daniel-theunissen/sar_adc/adc_tb.png

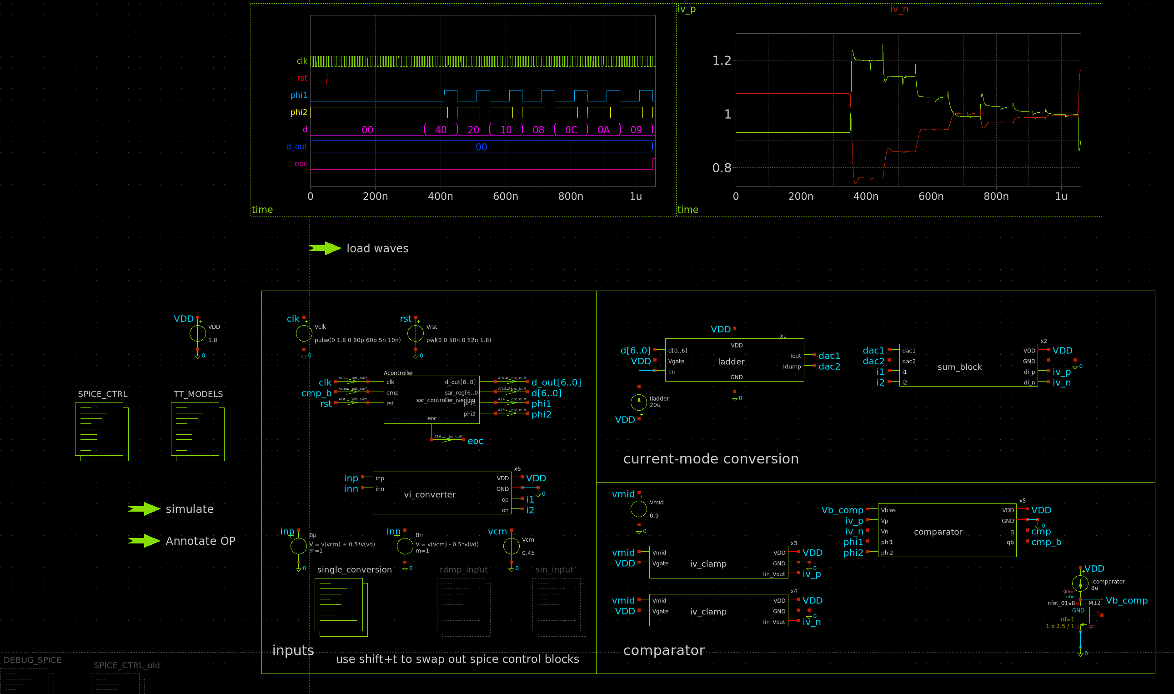
adc_tb.png
