daniel-theunissen/sar_adc/plots/clamp.png

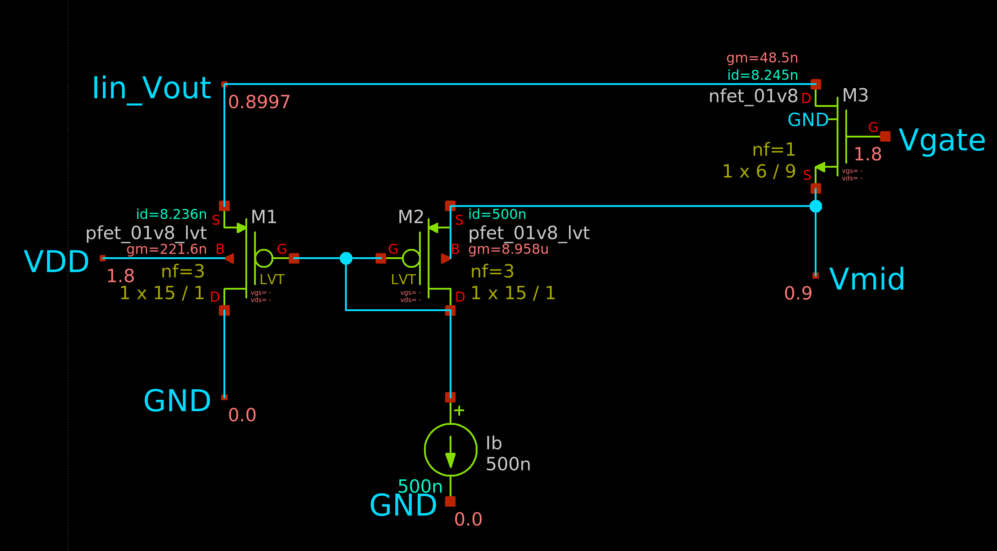
plots/clamp.png
