daniel-theunissen/sar_adc/plots/clamp_curve.png

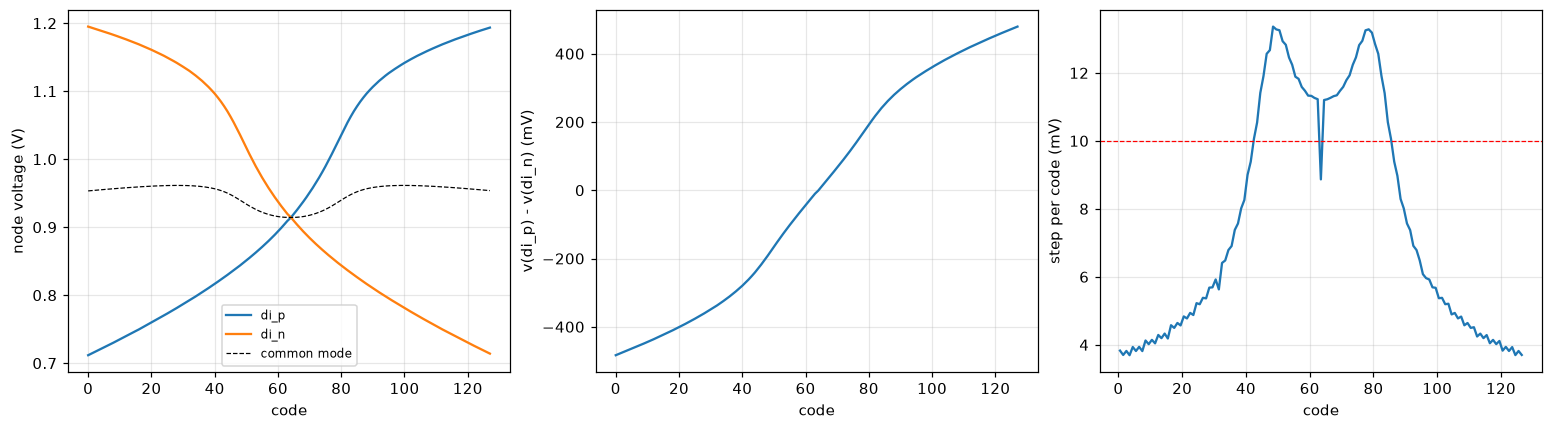
plots/clamp_curve.png
