daniel-theunissen/sar_adc/plots/comparator.png

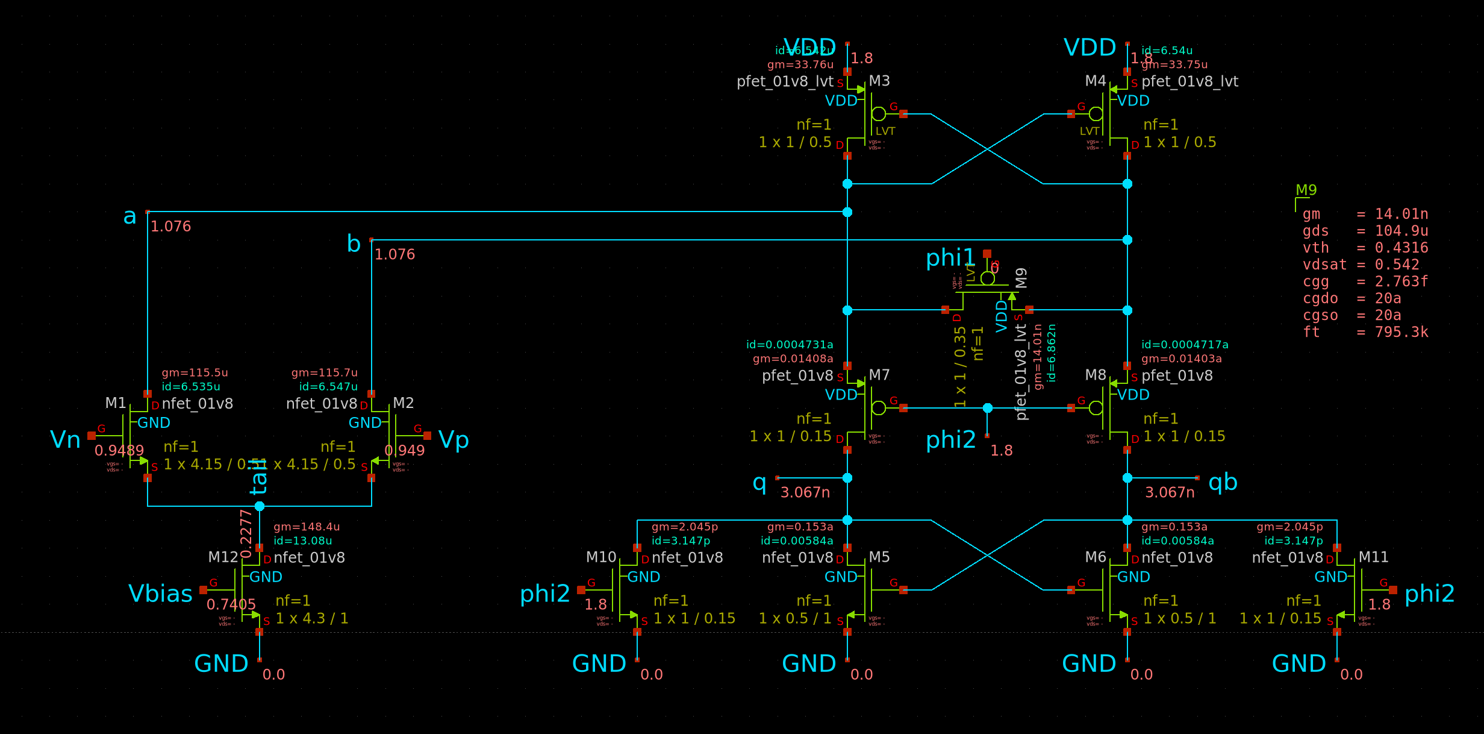
plots/comparator.png
