daniel-theunissen/sar_adc/plots/comparator_tb.png

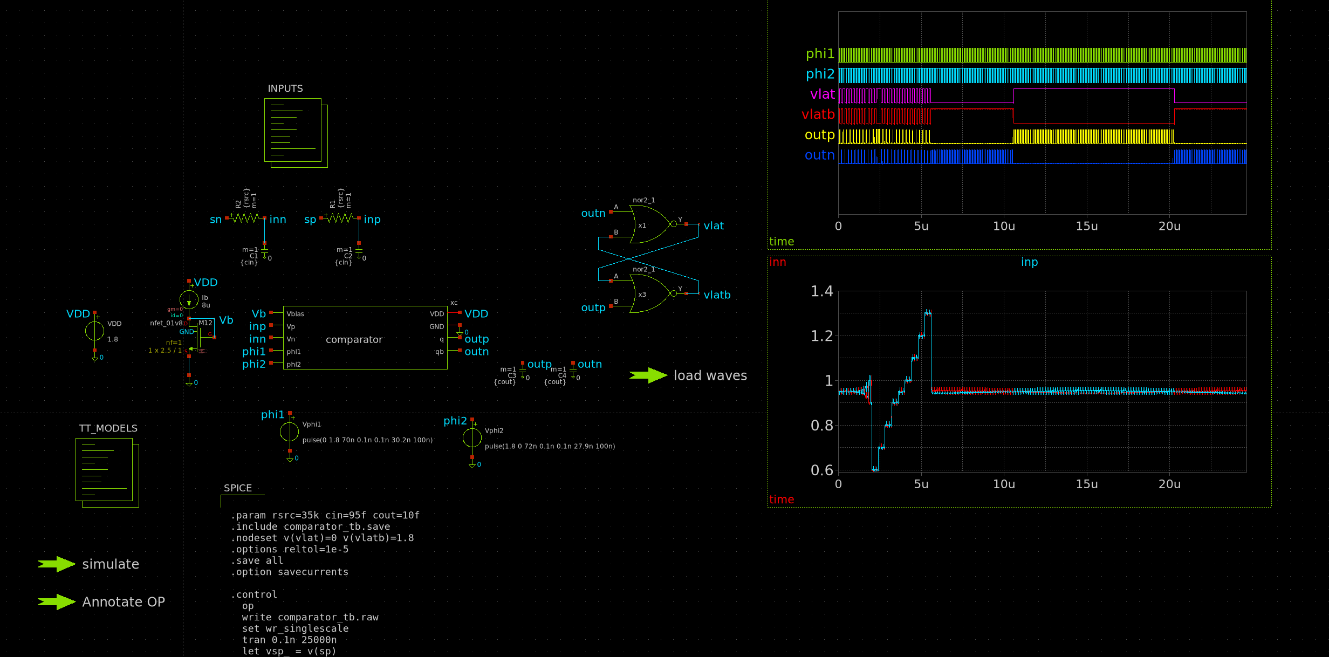
plots/comparator_tb.png
