daniel-theunissen/sar_adc/plots/ladder.png

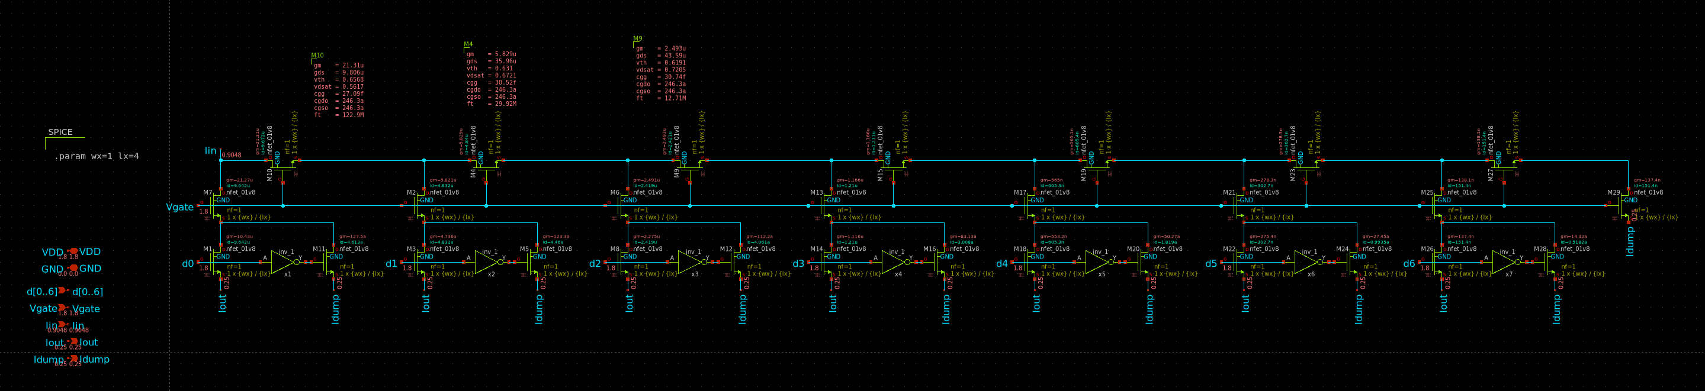
plots/ladder.png
