daniel-theunissen/sar_adc/plots/ladder_linearity.png

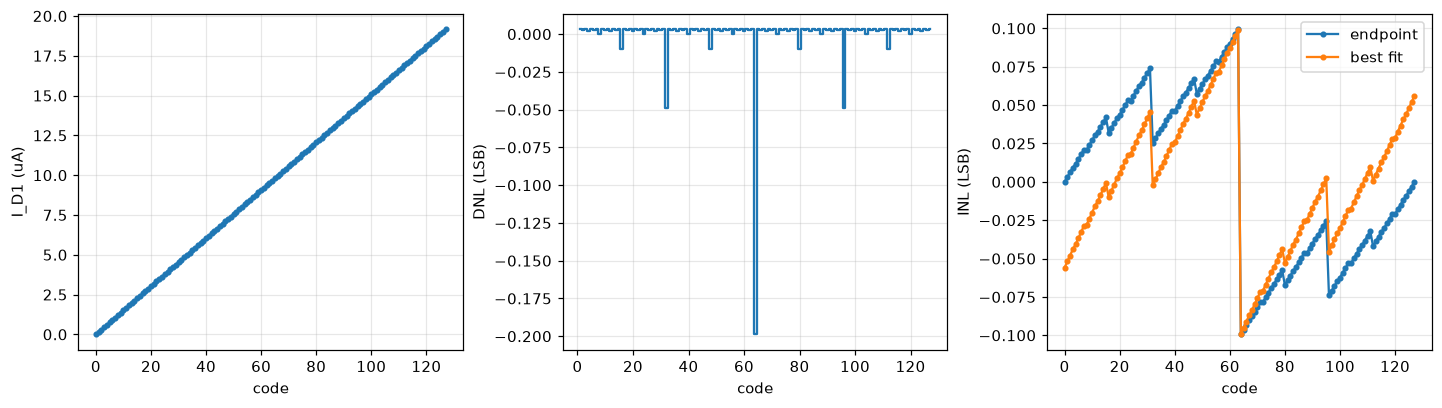
plots/ladder_linearity.png
