daniel-theunissen/sar_adc/plots/sum_stage.png

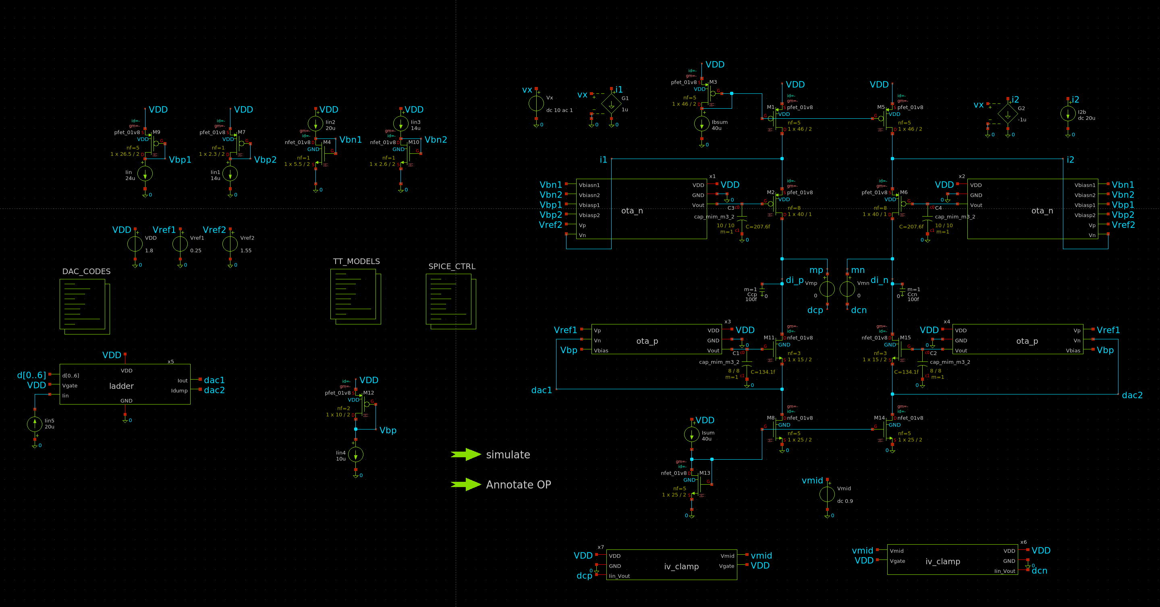
plots/sum_stage.png
