daniel-theunissen/sar_adc/plots/sum_stage_linearity.png

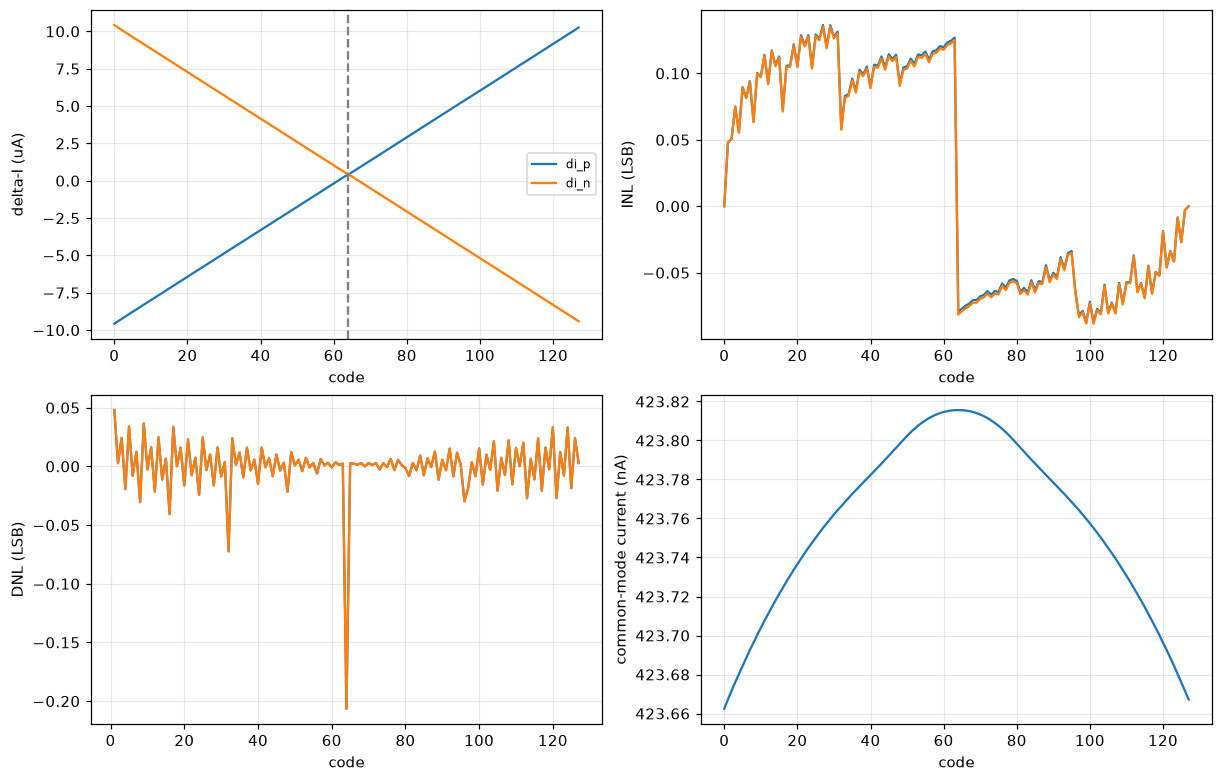
plots/sum_stage_linearity.png
