daniel-theunissen/sar_adc/plots/sum_stage_ota_n.png

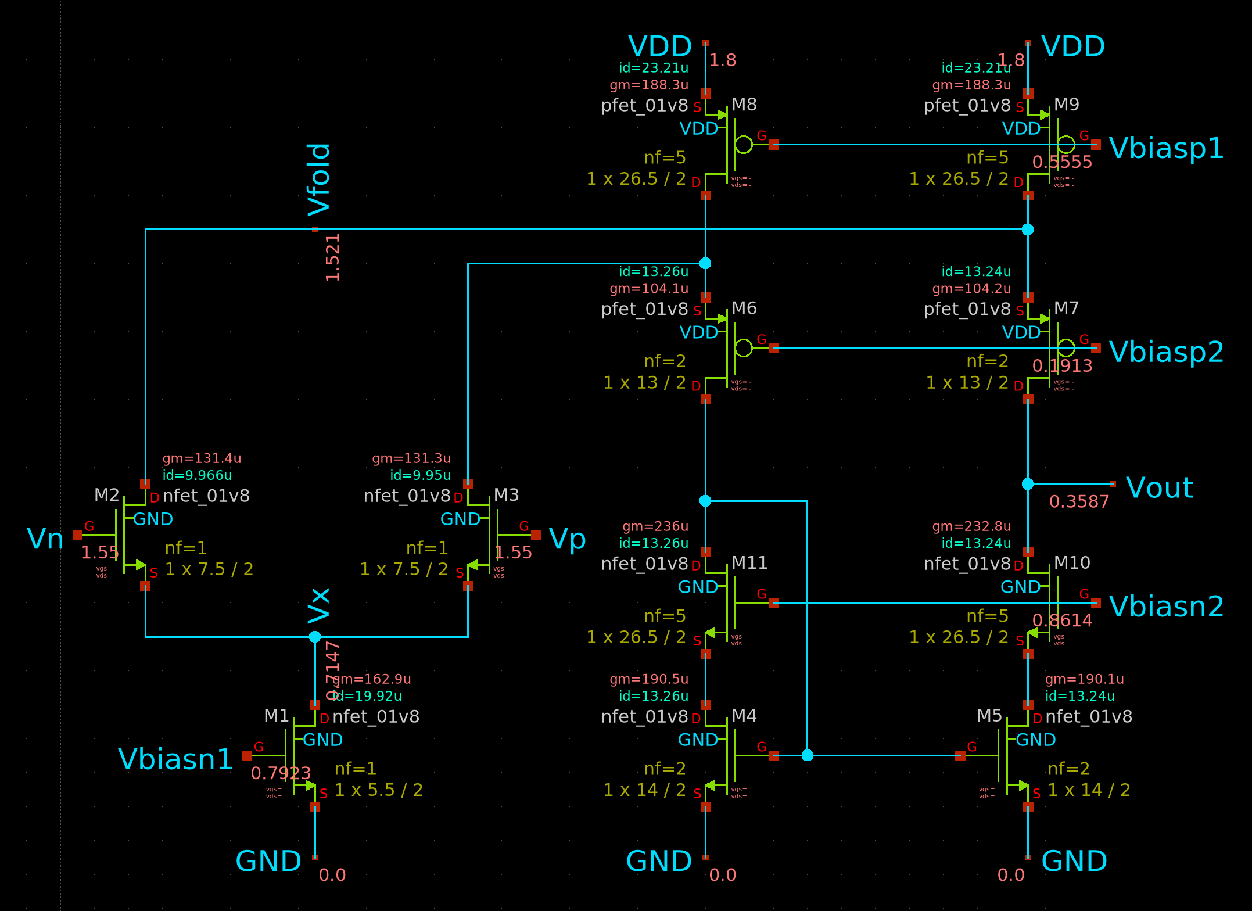
plots/sum_stage_ota_n.png
