daniel-theunissen/sar_adc/plots/sum_stage_ota_p.png

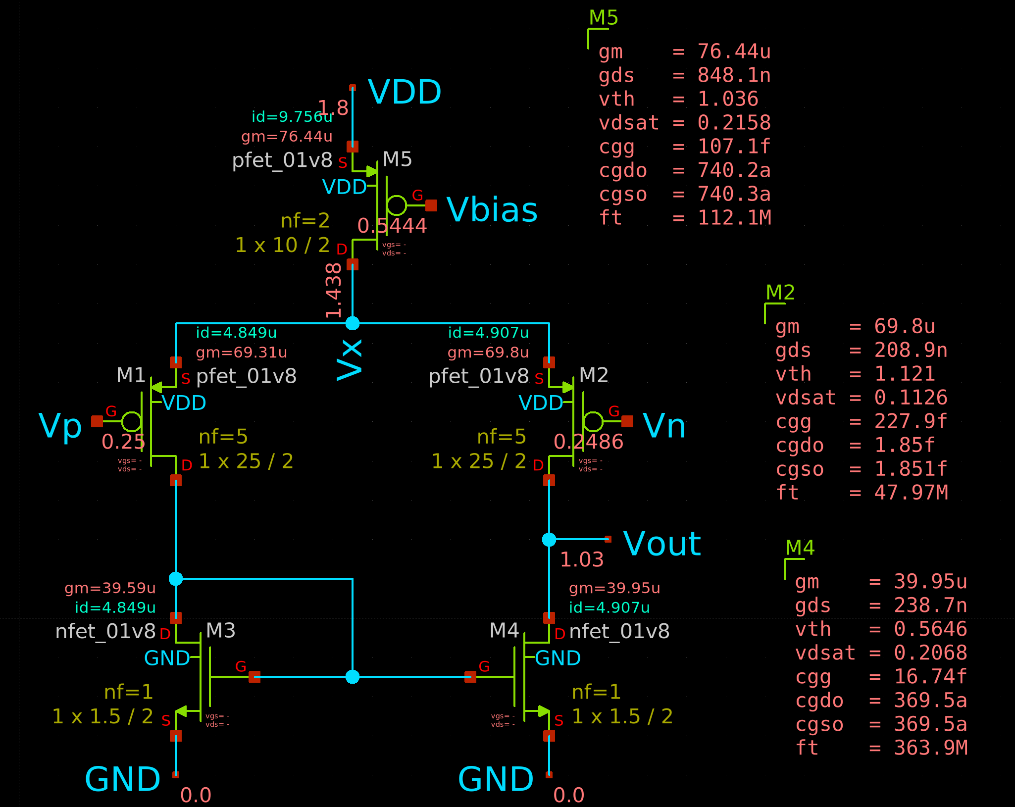
plots/sum_stage_ota_p.png
