daniel-theunissen/sar_adc/plots/vi_converter_amp.png

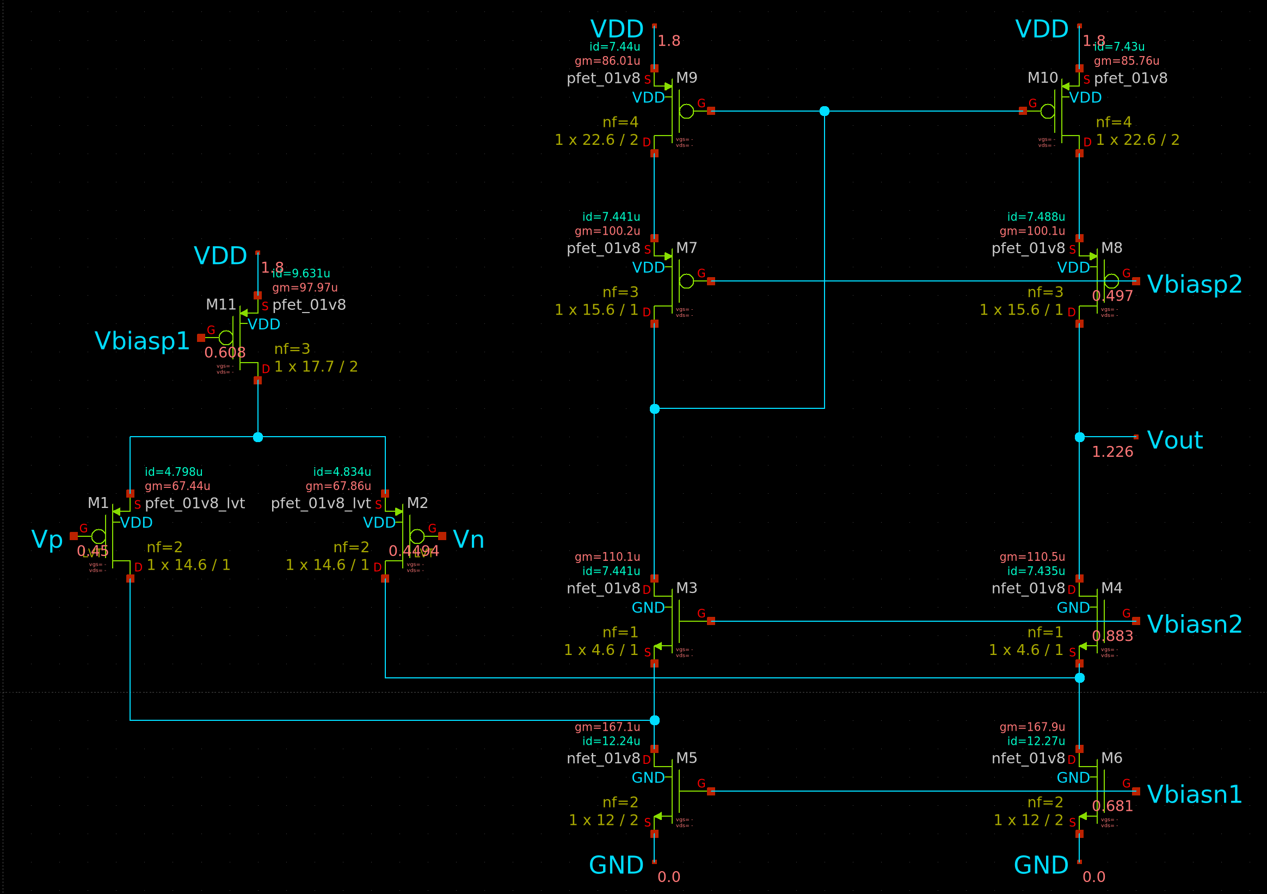
plots/vi_converter_amp.png
