daniel-theunissen/sar_adc/plots/vi_converter_amp_gain.png

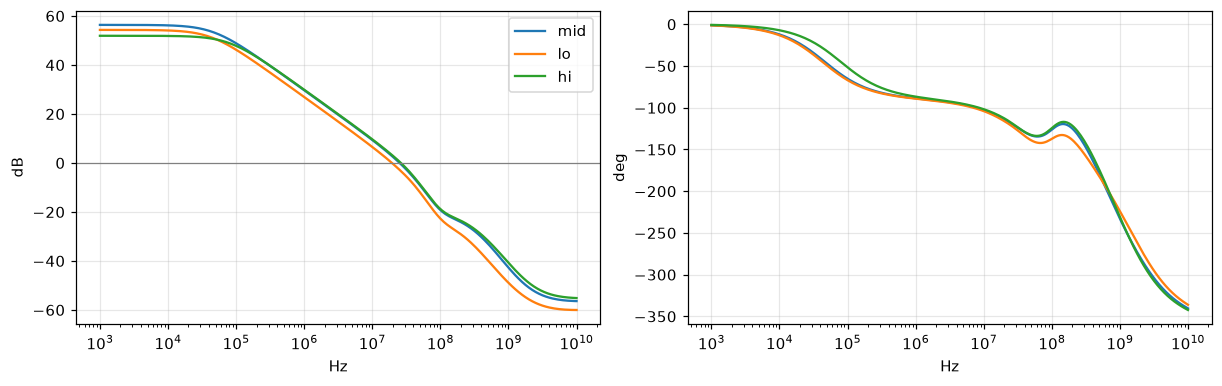
plots/vi_converter_amp_gain.png
