daniel-theunissen/sar_adc/plots/vi_converter_linearity.png

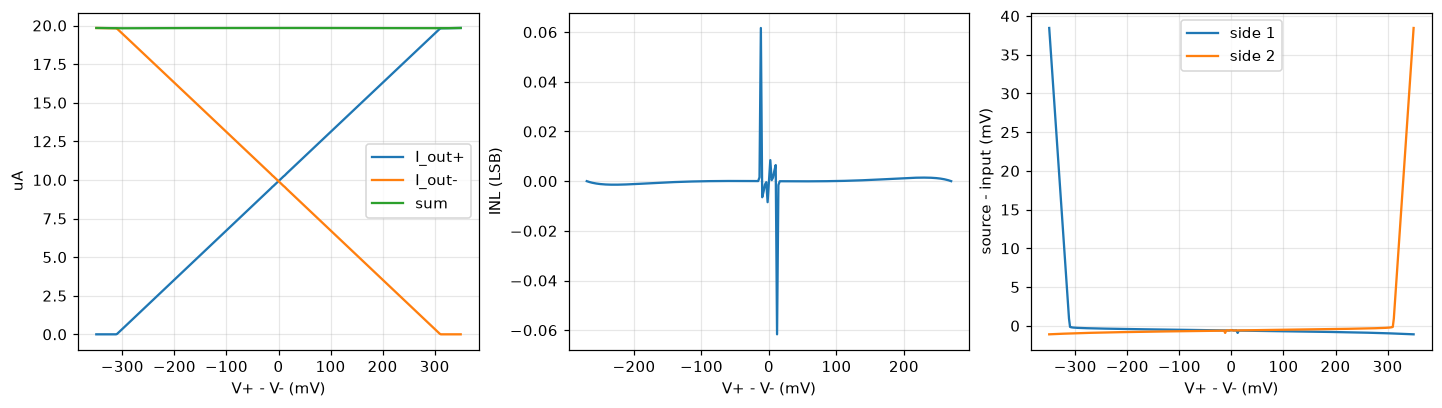
plots/vi_converter_linearity.png
