daniel-theunissen/sar_adc/plots/vi_converter_tb.png

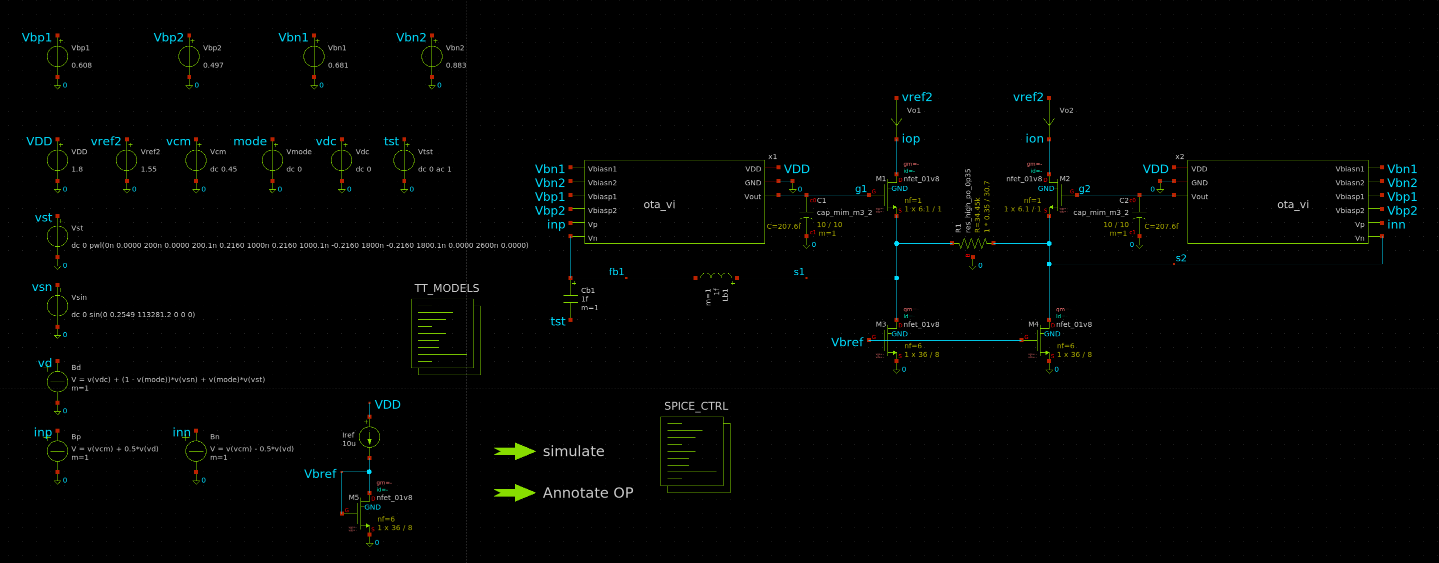
plots/vi_converter_tb.png
