daniel-theunissen/sar_adc/(commit log)

2026-10-28 Clean up project: shared sarlib package, single specs file, lean notebooks
    - sch/sarlib/specs.py: every sizing/analysis input and pass/fail limit
    - sch/sarlib/gmid.py, analysis.py: replace helpers duplicated across notebooks
    - sizing notebooks moved from gmid/ into their block folders
    - notebooks reduced to the analysis that produces the current results
    - stale schematics, notebooks and scripts moved to sch/archive/
    - ARCHITECTURE.md with the signal chain, design equations and results
    [5t_ota_n.sch, 5t_ota_n_ac.sch, 5t_ota_p.sch, 5t_ota_p_ac.sch, adc.sch, comparator.sch, comparator_tb.sch, current_sum.sch]
2026-10-28 Keep device sizing in the sizing notebooks; name analyses after their circuits
    - specs.py now holds only requirements, operating conditions, cross-block
    measured values and limits; gm/Id, L, currents and node plans moved into
    each sizing notebook; hand-estimate process constants moved to gmid.tech
    - bench_{c,d,e,f,g,vi}_analysis renamed after the circuit they analyse
    - summing stage: report the step per code at the decision point (11.3 mV)
    instead of the full-range endpoint average (7.58 mV), which the clamp
    compression pulls down; V_LSB_CMP updated to match
    - transresistance above 2 R_tr is reported, not failed: it comes from the
    common-mode current biasing both clamps onto the hi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
2026-10-30 refactor ladder analysis, clean up docs
    [adc.sch, ladder_tb.sch]
2026-10-31 add plots
    [comparator_tb.sch, iv_clamp_tb.sch, summing_stage_w_clamps.sch, vi_converter_tb.sch]
